amohammedabdelraheem1/se/Hardware/[DC.DC.301] DC-DC Step Down Converter 2A USB (9V-12V-24Vdc to Fixed Output 5V-2A) SKU#DC301.jpg

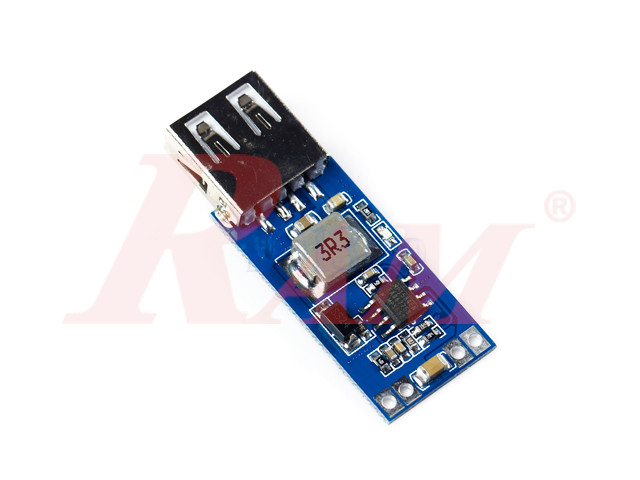
Hardware/[DC.DC.301] DC-DC Step Down Converter 2A USB (9V-12V-24Vdc to Fixed Output 5V-2A) SKU#DC301.jpg
