amohammedabdelraheem1/se/Hardware/bms-18650-3s.webp

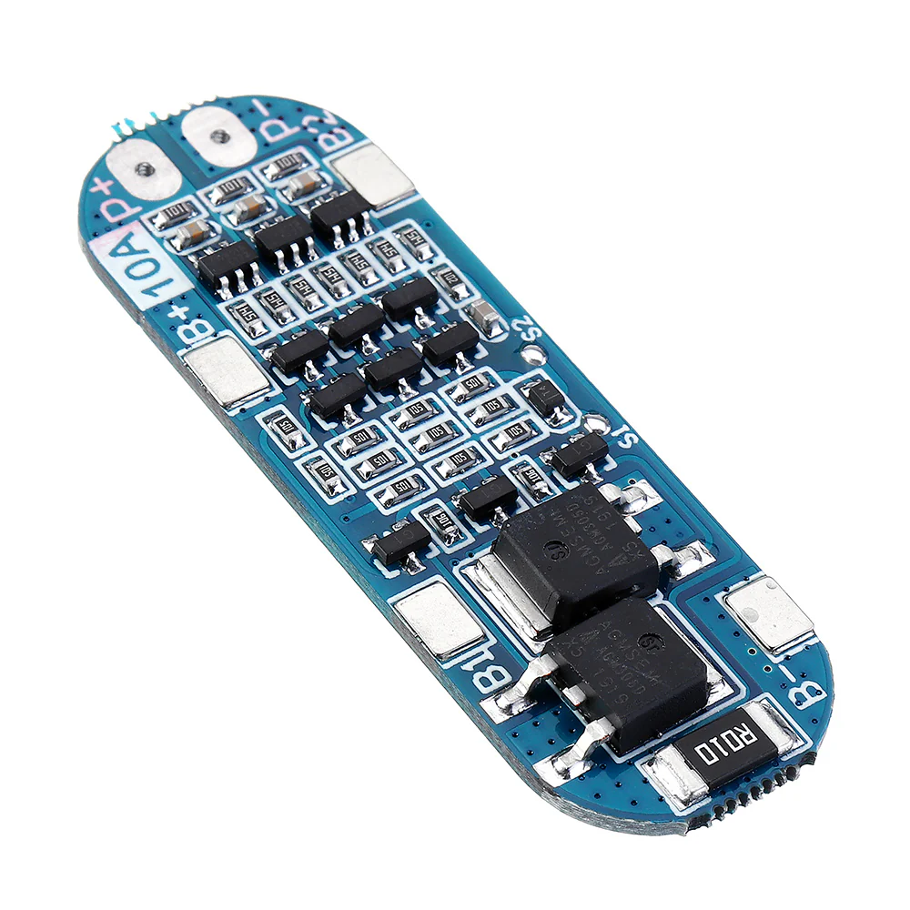
Hardware/bms-18650-3s.webp
