amohammedabdelraheem1/se/PCB/LockBoard/report.txt

Plotted to 'C:\Users\FUTURE\Documents\KiCad\8.0\projects\LockBoard\MainBoardGerber\LockBoard-F_Cu.gbr'.
Plotted to 'C:\Users\FUTURE\Documents\KiCad\8.0\projects\LockBoard\MainBoardGerber\LockBoard-B_Cu.gbr'.
Plotted to 'C:\Users\FUTURE\Documents\KiCad\8.0\projects\LockBoard\MainBoardGerber\LockBoard-F_Paste.gbr'.
Plotted to 'C:\Users\FUTURE\Documents\KiCad\8.0\projects\LockBoard\MainBoardGerber\LockBoard-B_Paste.gbr'.
Plotted to 'C:\Users\FUTURE\Documents\KiCad\8.0\projects\LockBoard\MainBoardGerber\LockBoard-F_Silkscreen.gbr'.
Plotted to 'C:\Users\FUTURE\Documents\KiCad\8.0\projects\LockBoard\MainBoardGerber\LockBoard-B_Silkscreen.gbr'.
Plotted to 'C:\Users\FUTURE\Documents\KiCad\8.0\projects\LockBoard\MainBoardGerber\LockBoard-F_Mask.gbr'.
Plotted to 'C:\Users\FUTURE\Documents\KiCad\8.0\projects\LockBoard\MainBoardGerber\LockBoard-B_Mask.gbr'.
Plotted to 'C:\Users\FUTURE\Documents\KiCad\8.0\projects\LockBoard\MainBoardGerber\LockBoard-Edge_Cuts.gbr'.
Created Gerber job file 'C:\Users\FUTURE\Documents\KiCad\8.0\projects\LockBoard\MainBoardGerber\LockBoard-job.gbrjob'.
Info: Done.
