amohammedabdelraheem1/se/Design/BlockDiagram.png

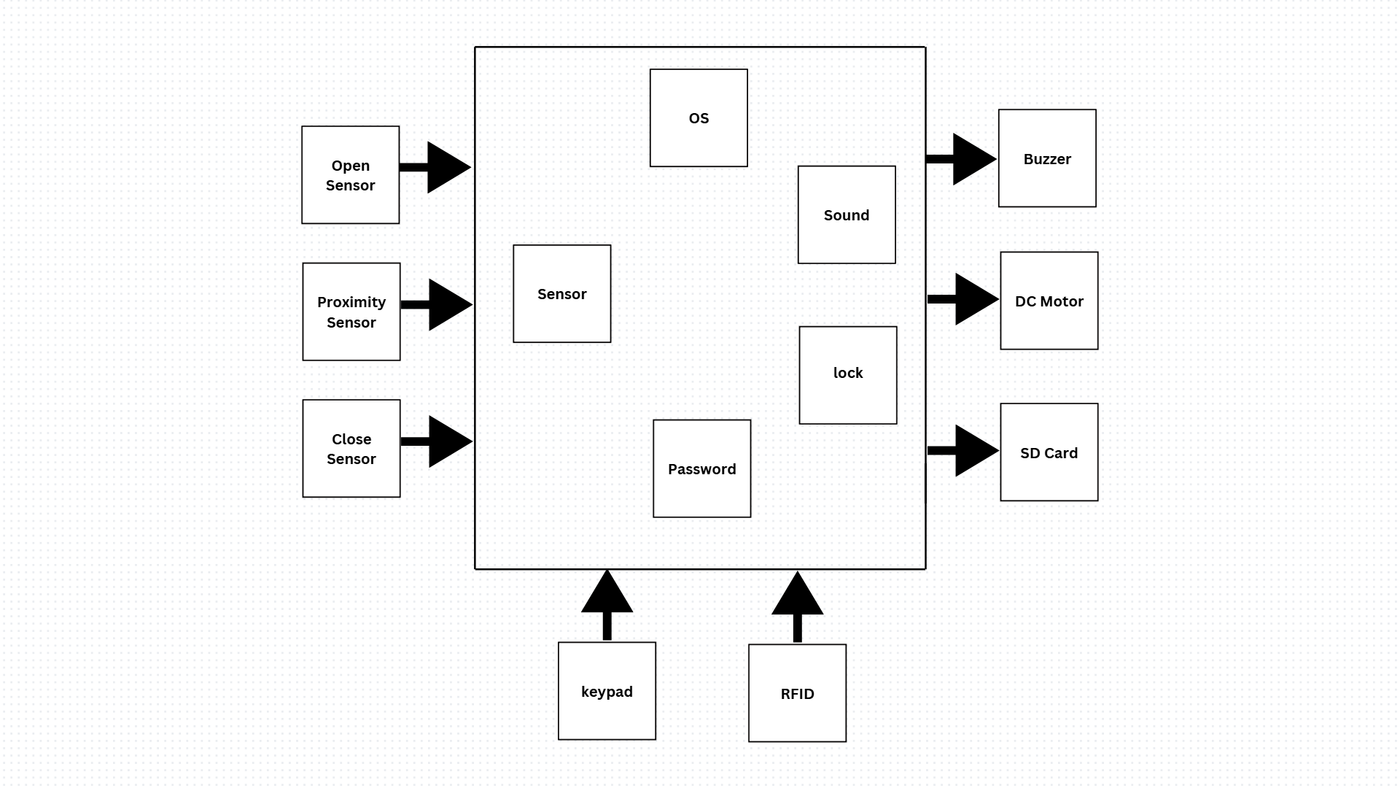
Design/BlockDiagram.png
