amohammedabdelraheem1/se/Design/Modules.png

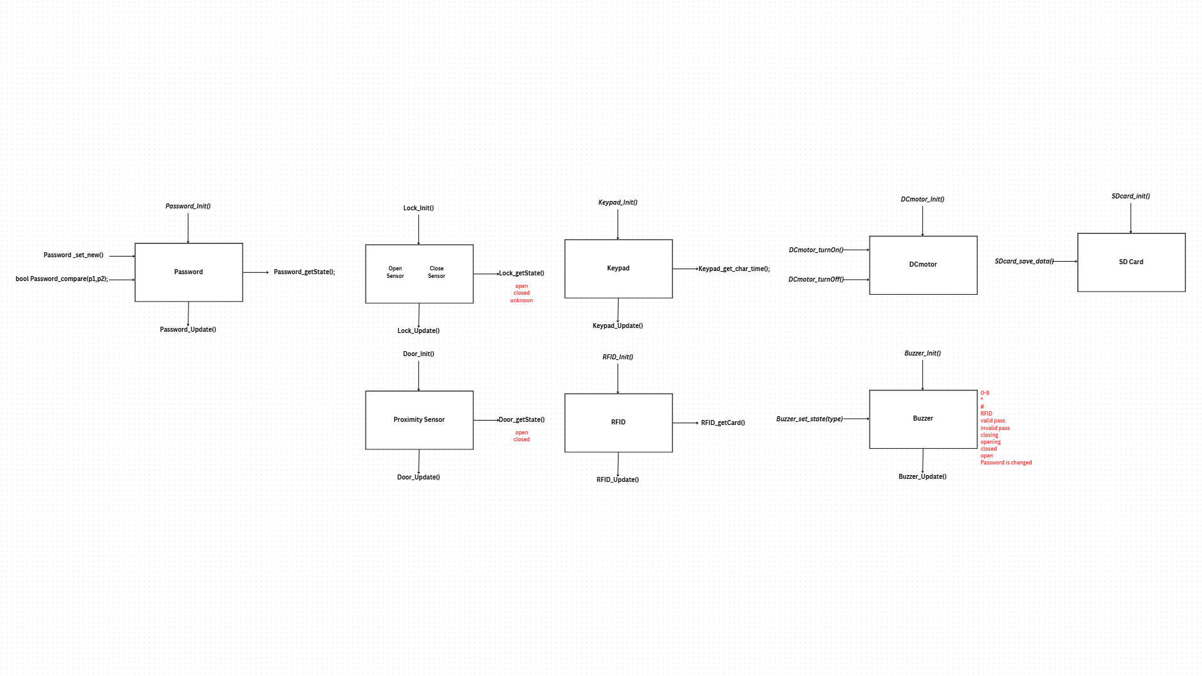
Design/Modules.png
