amohammedabdelraheem1/se/Design/StateMachine.png

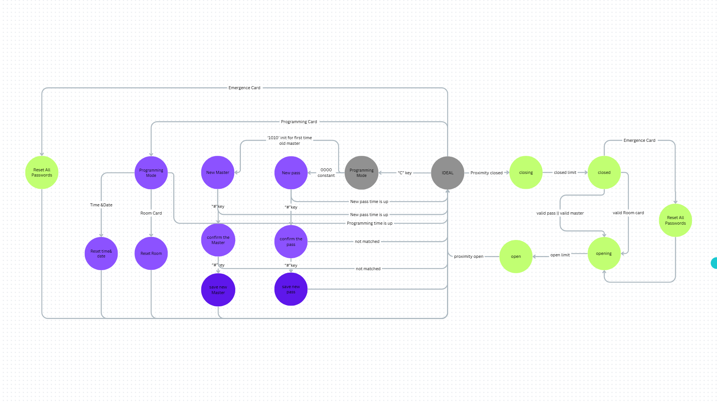
Design/StateMachine.png
