amohammedabdelraheem1/se/Hardware/6pin_diag.png

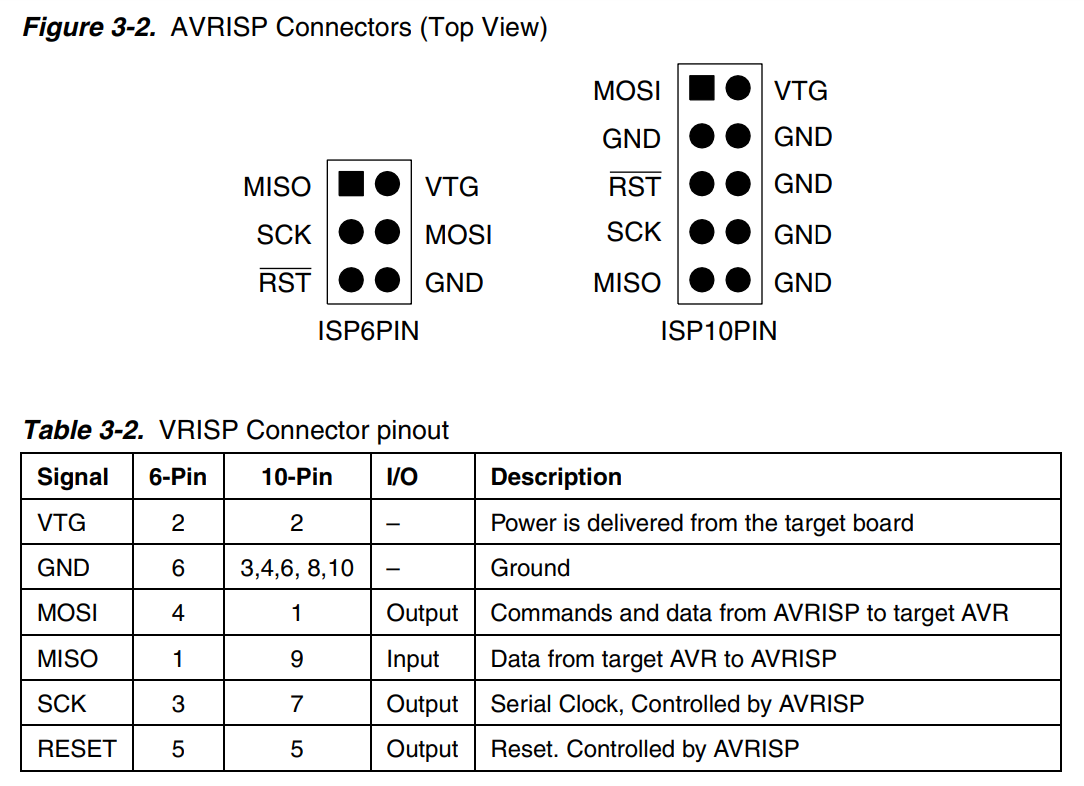
Hardware/6pin_diag.png
