amohammedabdelraheem1/se/Hardware/bat-02-096-1-usb-output-9v-24v-to.jpg

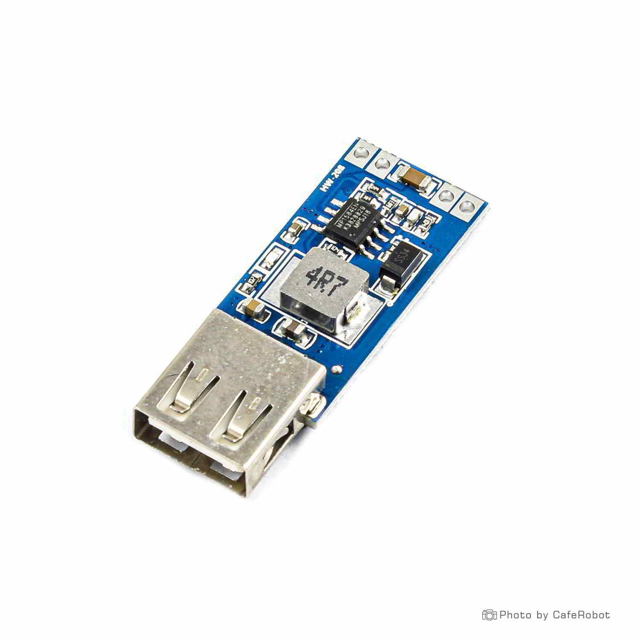
Hardware/bat-02-096-1-usb-output-9v-24v-to.jpg
