amohammedabdelraheem1/se/Hardware/bat-02-096-7-usb-output-9v-24v-to.jpg

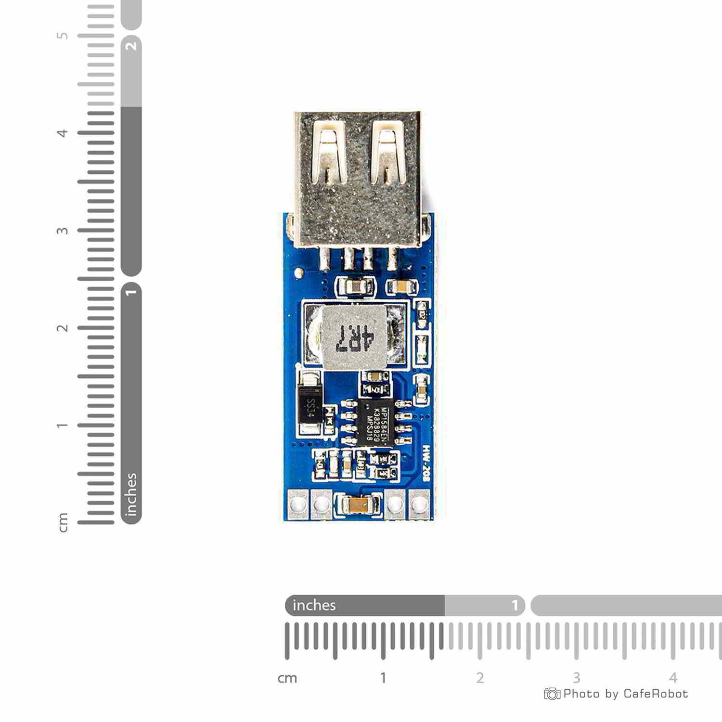
Hardware/bat-02-096-7-usb-output-9v-24v-to.jpg
