amohammedabdelraheem1/se/Hardware/pin_connection.PNG

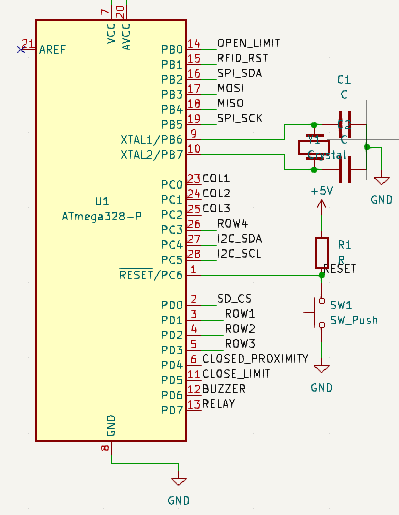
Hardware/pin_connection.PNG
