amohammedabdelraheem1/se/PCB/LockBoard/LockBoard1.png

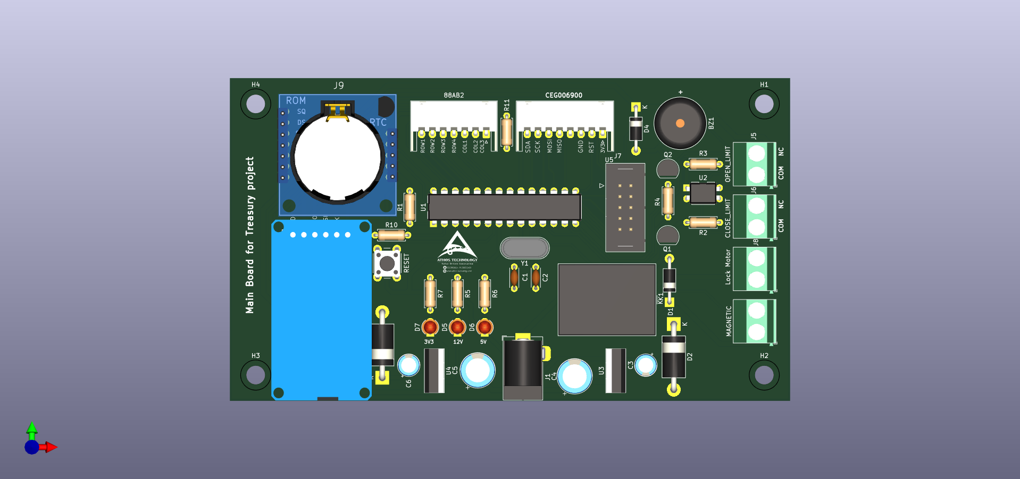
PCB/LockBoard/LockBoard1.png
