amohammedabdelraheem1/se/PCB/PowerBoard/PowerBoard1.jpg

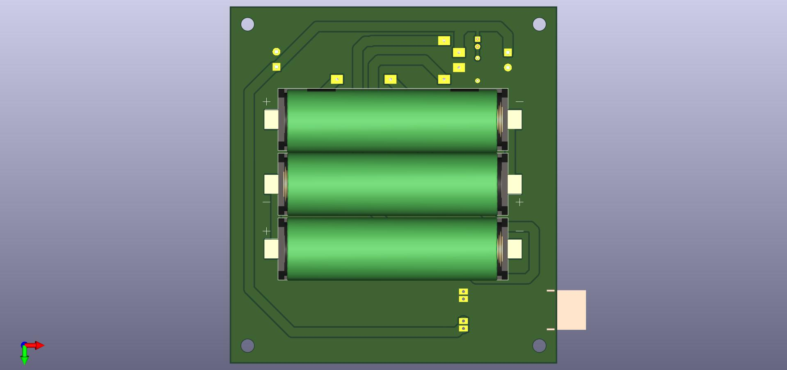
PCB/PowerBoard/PowerBoard1.jpg
