amohammedabdelraheem1/se/PCB/PowerBoard/PowerBoard.jpg

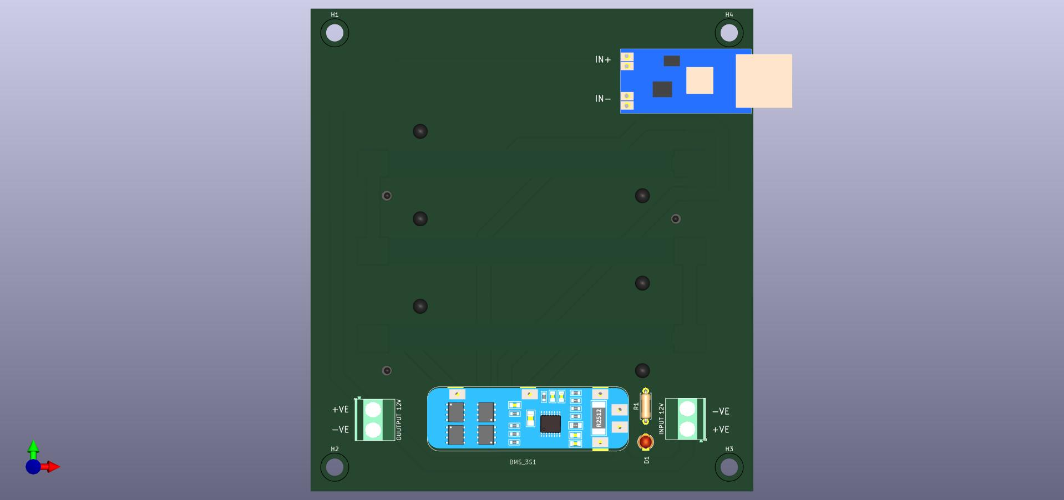
PCB/PowerBoard/PowerBoard.jpg
