amohammedabdelraheem1/se/PCB/PowerBoard/PowerBoard.png

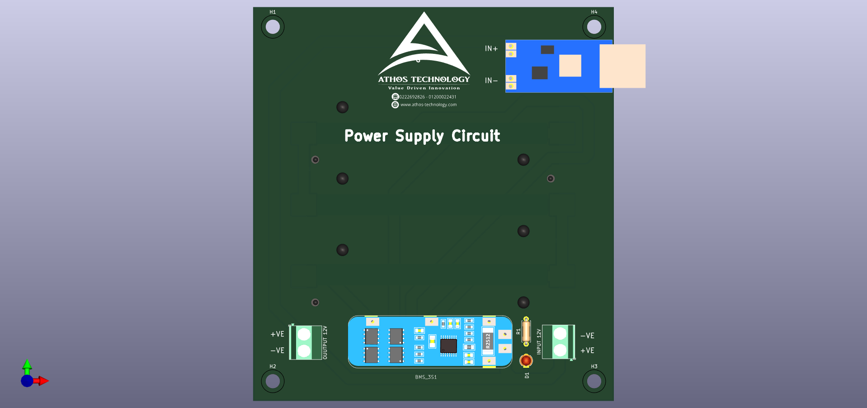
PCB/PowerBoard/PowerBoard.png
