amohammedabdelraheem1/se/(list of files, drawings)

Other design files:
PCB/LockBoard/LockBoard.dsn
