amohammedabdelraheem1/se/PCB/LockBoard/LockBoard.kicad_pcb

## KiCad design PCB/LockBoard/LockBoard.kicad_pcb (2025-07-10)

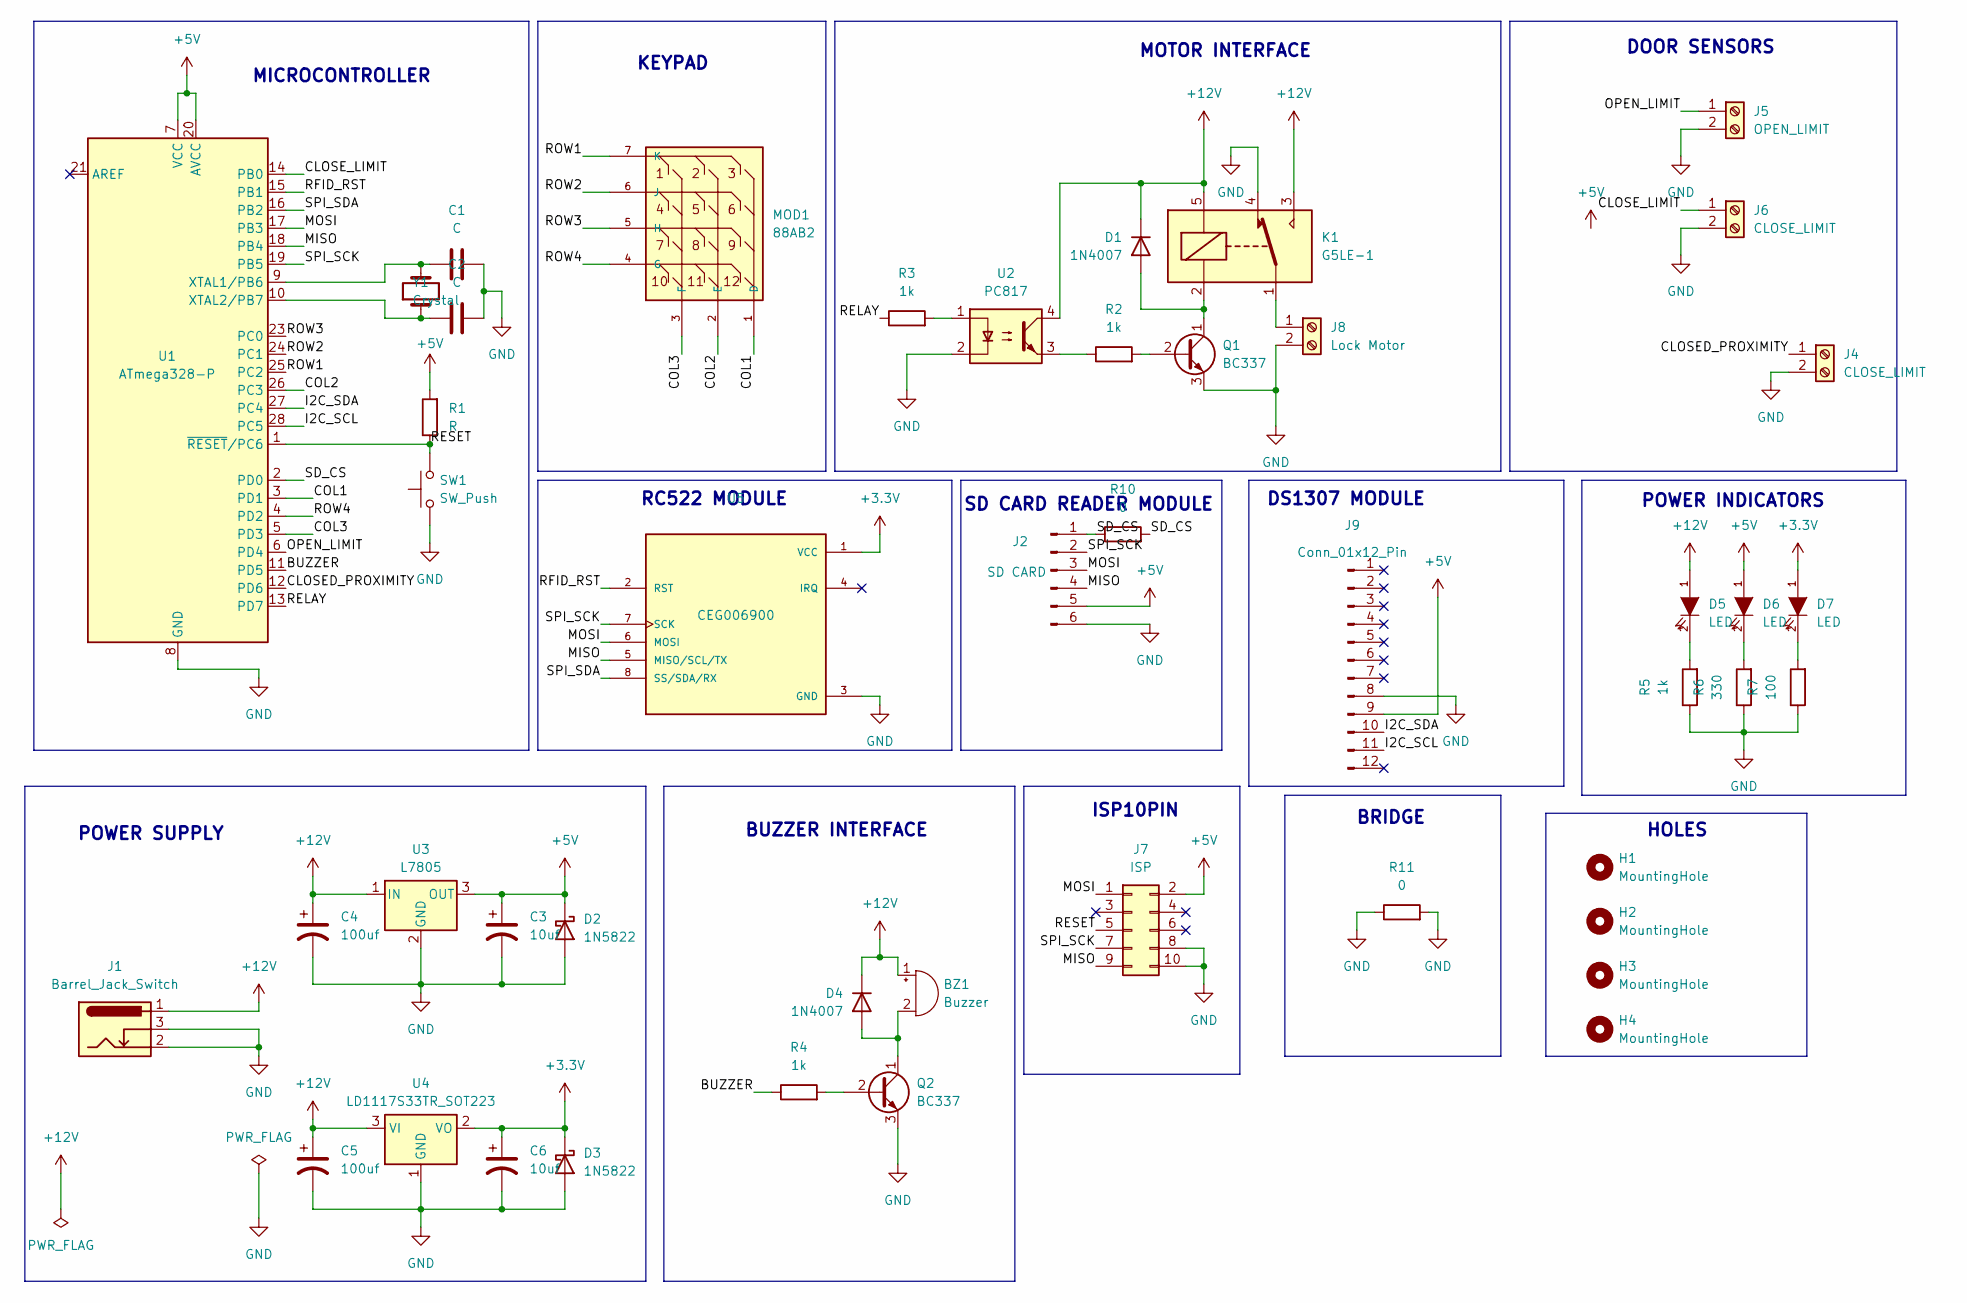
[picture p15: schematic LockBoard.kicad_sch, Lock Board]

Parts:
BZ1: Buzzer; Buzzer_12x9.5RM7.6
C1, C2: C; C_Disc_D4.3mm_W1.9mm_P5.00mm
C3, C6: 10uf; CP_Radial_D5.0mm_P2.50mm
C4, C5: 100uf; CP_Radial_D8.0mm_P2.50mm
D1, D4: 1N4007; D_DO-41_SOD81_P10.16mm_Horizontal
D2, D3: 1N5822; D_DO-201AD_P15.24mm_Horizontal
D5, D6, D7: LED; LED_D3.0mm
H1, H2, H3, H4: MountingHole; MountingHole_4.3mm_M4_ISO14580
J1: Barrel_Jack_Switch; BarrelJack_Horizontal
J2: SD CARD; SD_Card_Module
J4, J6: CLOSE_LIMIT; TerminalBlock_Phoenix_MKDS-1,5-2_1x02_P5.00mm_Horizontal
J5: OPEN_LIMIT; TerminalBlock_Phoenix_MKDS-1,5-2_1x02_P5.00mm_Horizontal
J7: ISP; IDC-Header_2x05_P2.54mm_Vertical
J8: Lock Motor; TerminalBlock_Phoenix_MKDS-1,5-2_1x02_P5.00mm_Horizontal
J9: Conn_01x12_Pin; Tiny_RTC_DS1307
K1: G5LE-1; Relay_SPDT_Omron-G5LE-1
MOD1: 88AB2; JST_XH_S7B-XH-A-1_1x07_P2.50mm_Horizontal
Q1, Q2: BC337; TO-92_Inline
R1: R; R_Axial_DIN0207_L6.3mm_D2.5mm_P7.62mm_Horizontal
R2, R3, R4, R5: 1k; R_Axial_DIN0207_L6.3mm_D2.5mm_P7.62mm_Horizontal
R6: 330; R_Axial_DIN0207_L6.3mm_D2.5mm_P7.62mm_Horizontal
R7: 100; R_Axial_DIN0207_L6.3mm_D2.5mm_P7.62mm_Horizontal
R10, R11: 0; R_Axial_DIN0207_L6.3mm_D2.5mm_P7.62mm_Horizontal
SW1: SW_Push; SW_PUSH_6mm
U1: ATmega328-P; DIP-28_W7.62mm
U2: PC817; DIP-4_W7.62mm
U3: L7805; TO-220-3_Vertical
U4: LD1117S33TR_SOT223; TO-220-3_Vertical
U5: CEG006900; JST_XH_S8B-XH-A-1_1x08_P2.50mm_Horizontal; PARTREV 12 June 2019
Y1: Crystal; Crystal_HC49-4H_Vertical

Connections:
+3.3V: C6.1, D3.1 (K), D7.1 (A), U4.2 (VO), U5.1 (VCC)
+5V: C3.1, D2.1 (K), D6.1 (A), J2.5, J7.2, J9.9, R1.2, U1.7 (VCC), U1.20 (AVCC), U3.3 (OUT)
+12V: BZ1.1 (+), C4.1, C5.1, D1.1 (K), D4.1 (K), D5.1 (A), J1.1, K1.3, K1.5, U2.4, U3.1 (IN), U4.3 (VI)
/BUZZER: R4.1, U1.11 (PD5)
/CLOSED_PROXIMITY: J4.1, U1.12 (PD6); also elsewhere on the board
/CLOSE_LIMIT: J6.1, U1.14 (PB0)
/COL1: MOD1.1 (D), U1.3 (PD1)
/COL2: MOD1.2 (E), U1.26 (PC3)
/COL3: MOD1.3 (F), U1.5 (PD3)
/I2C_SCL: J9.11, U1.28 (PC5)
/I2C_SDA: J9.10, U1.27 (PC4)
/MISO: J2.4, J7.9, U1.18 (PB4), U5.5 (MISO/SCL/TX)
/MOSI: J2.3, J7.1, U1.17 (PB3), U5.6 (MOSI)
/OPEN_LIMIT: J5.1, U1.6 (PD4)
/RELAY: R3.1, U1.13 (PD7)
/RESET: J7.5, R1.1, SW1.2, U1.1 (~RESET/PC6)
/RFID_RST: U1.15 (PB1), U5.2 (RST)
/ROW1: MOD1.7 (K), U1.25 (PC2)
/ROW2: MOD1.6 (J), U1.24 (PC1)
/ROW3: MOD1.5 (H), U1.23 (PC0)
/ROW4: MOD1.4 (G), U1.4 (PD2)
/SD_CS: J2.1, R10.1, R10.2, U1.2 (PD0)
/SPI_SCK: J2.2, J7.7, U1.19 (PB5), U5.7 (SCK)
/SPI_SDA: U1.16 (PB2), U5.8 (SS/SDA/RX)
GND: C1.2, C2.2, C3.2, C4.2, C5.2, C6.2, D2.2 (A), D3.2 (A), J1.2, J1.3, J2.6, J4.2, J5.2, J6.2, J7.8, J7.10, J8.2, J9.8, K1.4, Q1.3 (E), Q2.3 (E), R5.1, R6.1, R7.1, R11.1, R11.2, SW1.1, U1.8 (GND), U1.22 (GND), U2.2, U3.2 (GND), U4.1 (GND), U5.3 (GND); also elsewhere on the board
unnamed: BZ1.2 (-), D4.2 (A), Q2.1 (C)
unnamed: D1.2 (A), K1.2, Q1.1 (C)
unnamed: D5.2 (K), R5.2
unnamed: D6.2 (K), R6.2
unnamed: D7.2 (K), R7.2
unnamed: J8.1, K1.1
unnamed: Q1.2 (B), R2.2
unnamed: Q2.2 (B), R4.2
unnamed: R2.1, U2.3
unnamed: R3.2, U2.1
unnamed: C1.1, U1.9 (XTAL1/PB6), Y1.2
unnamed: C2.1, U1.10 (XTAL2/PB7), Y1.1

Notes on the sheet:
MOTOR INTERFACE
HOLES
BRIDGE
POWER SUPPLY
POWER INDICATORS
ISP10PIN
BUZZER INTERFACE
DOOR SENSORS
SD CARD READER MODULE
RC522 MODULE
DS1307 MODULE
MICROCONTROLLER
KEYPAD

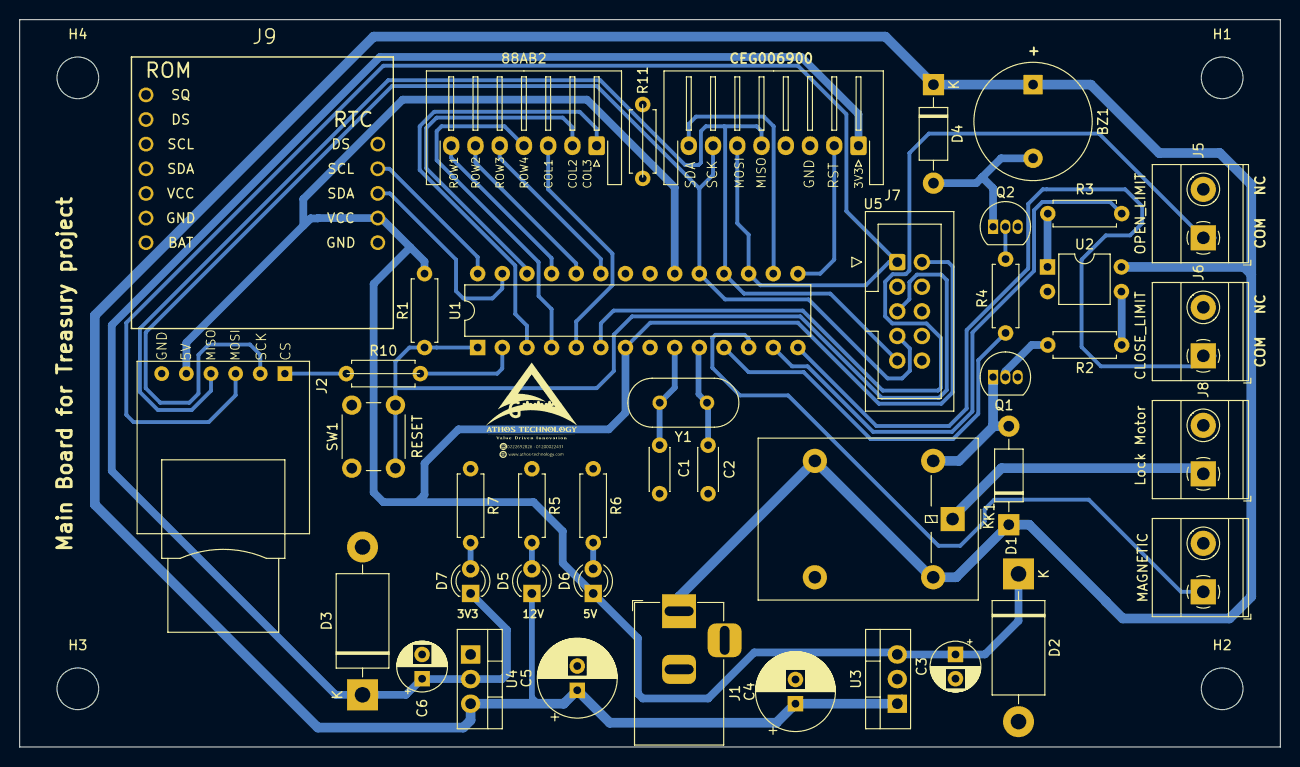
[picture p16: board LockBoard.kicad_pcb from above]

Board: 2 copper layers, 130.0 x 75.0 mm, 46 parts (0 on the bottom side), 37 nets.

Other parts of the board:
MAGNETIC: CLOSE_LIMIT; TerminalBlock_Phoenix_MKDS-1,5-2_1x02_P5.00mm_Horizontal

Their connections:
/CLOSED_PROXIMITY: MAGNETIC.1; also elsewhere on the board
GND: MAGNETIC.2; also elsewhere on the board
