amohammedabdelraheem1/se/PCB/PowerBoard/PowerBoard.kicad_pcb

## KiCad design PCB/PowerBoard/PowerBoard.kicad_pcb (2025-07-10)

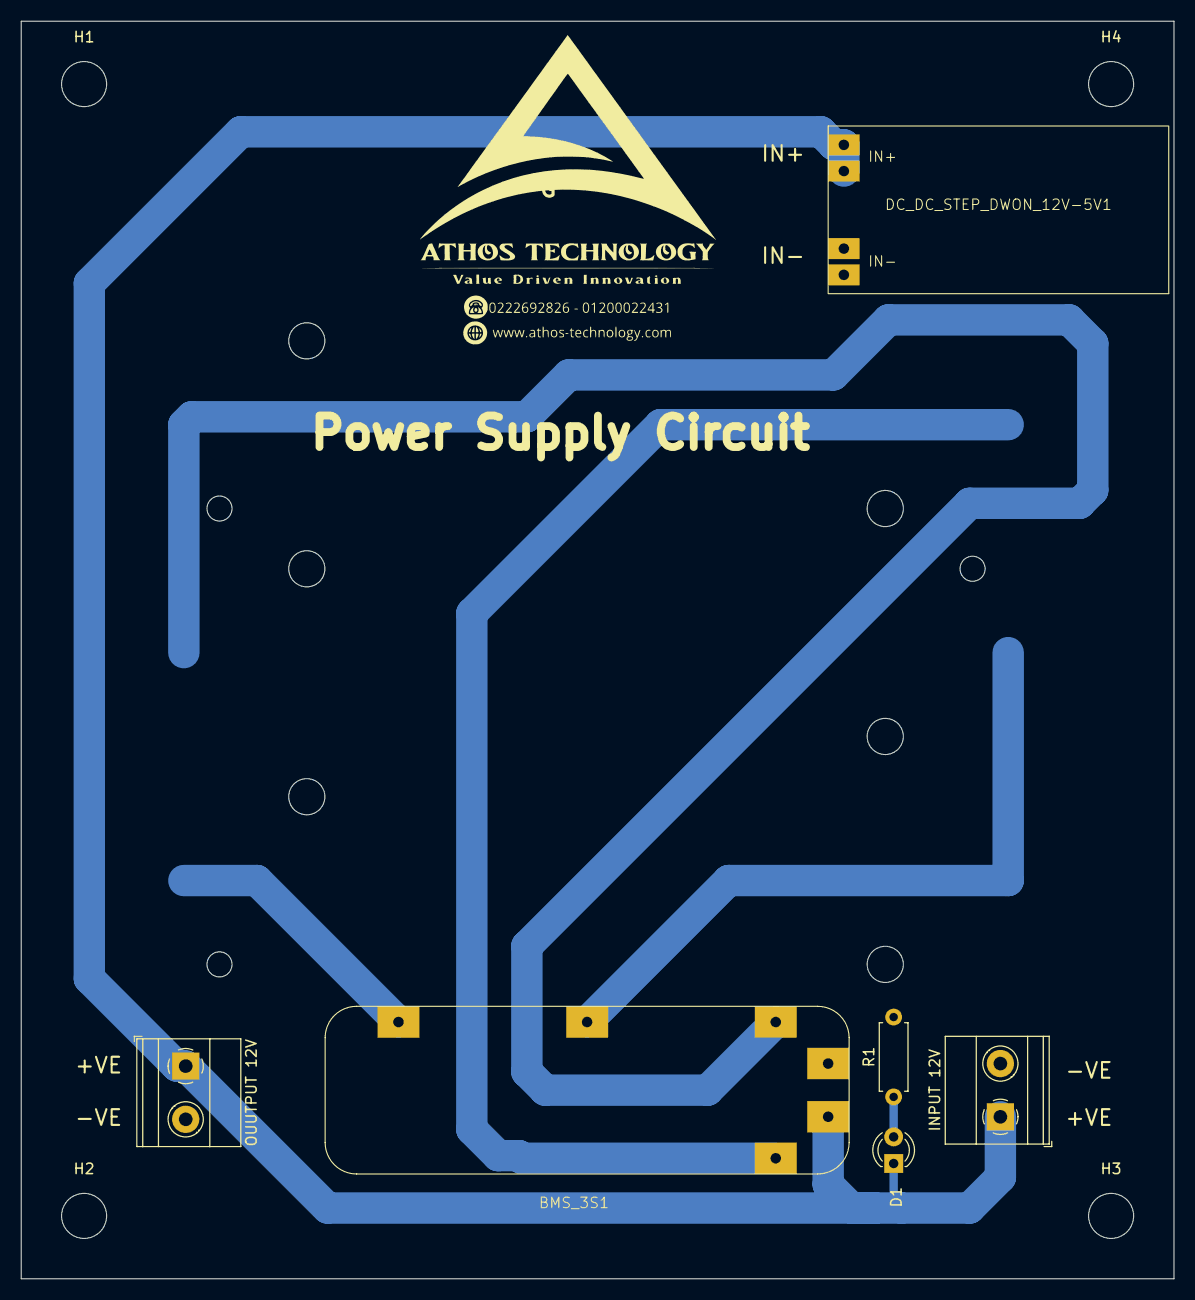
[picture p17: board PowerBoard.kicad_pcb from above]

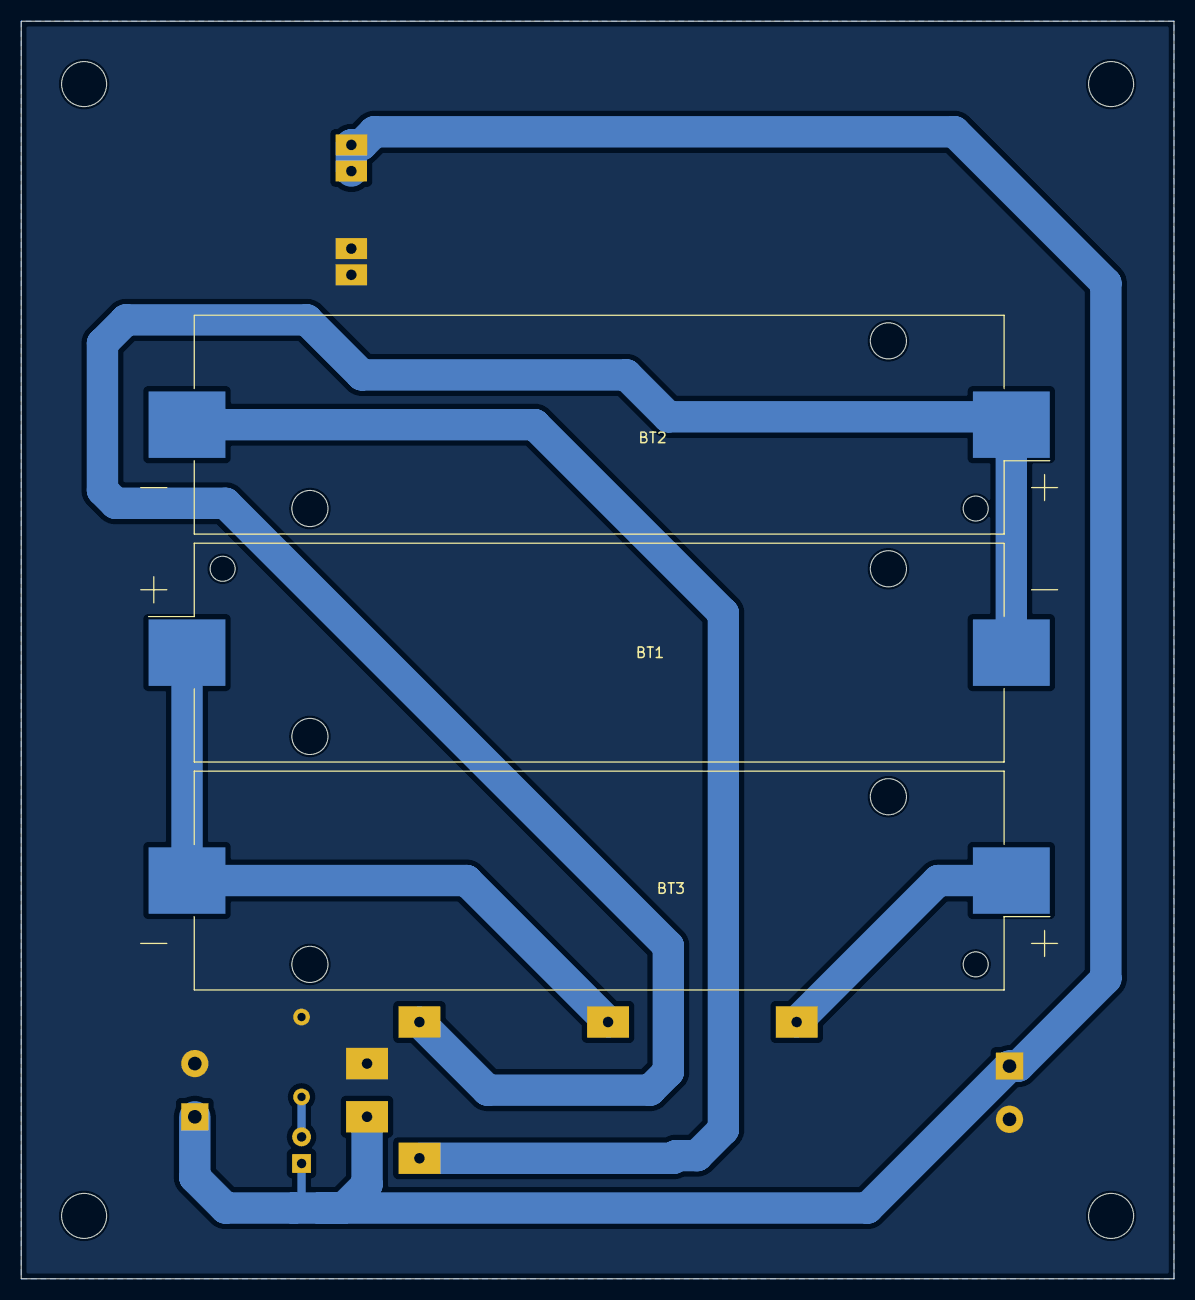
[picture p18: board PowerBoard.kicad_pcb from below]

Board: 2 copper layers, 110.0 x 120.0 mm, 13 parts (3 on the bottom side), 7 nets.

Parts:
BMS_3S1: BMS_3S
BT1, BT2, BT3: Battery_Cell; BatteryHolder_Keystone_1042_1x18650
D1: LED; LED_D3.0mm
DC_DC_STEP_DWON_12V-5V1: DC_DC_STEP_DOWN_12V-5V
H1, H2, H3, H4: MountingHole; MountingHole_4.3mm_M4_ISO14580
INPUT 12V: IN; TerminalBlock_Phoenix_MKDS-1,5-2-5.08_1x02_P5.08mm_Horizont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
OUUTPUT 12V: OUT; TerminalBlock_Phoenix_MKDS-1,5-2-5.08_1x02_P5.08mm_Horizont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
R1: R; R_Axial_DIN0207_L6.3mm_D2.5mm_P7.62mm_Horizontal

Connections:
+12V: BMS_3S1.6 (P+), D1.1 (A), DC_DC_STEP_DWON_12V-5V1.1 (in+), INPUT 12V.1, OUUTPUT 12V.1
GND: BMS_3S1.5 (P-), DC_DC_STEP_DWON_12V-5V1.2 (in-), INPUT 12V.2, OUUTPUT 12V.2, R1.2
unnamed: BMS_3S1.2 (B1), BT1.1 (+), BT2.2 (-)
unnamed: BMS_3S1.3 (B2), BT2.1 (+), BT3.2 (-)
unnamed: BMS_3S1.4 (B+), BT3.1 (+)
unnamed: BMS_3S1.1 (B-), BT1.2 (-)
unnamed: D1.2 (K), R1.1
