amohammedabdelraheem1/se/Code/Safe_lock_project/rfid.h

/******************************************************************************

   Module: RFID

   Description: Header file for the RFID driver

   Author: Ahmed Mohammed Abdelraheem

 ******************************************************************************/

#ifndef RFID_H_
#define RFID_H_
#include <MFRC522.h>
#include <Arduino.h>
#include "common_types.h"
/**************************************************************/
#ifdef __cplusplus
extern "C" {
#endif // __cplusplus
#define TYPE_BYTE_NUM 0
#define ID_BYTE_NUM 3
#define MONTH_DAY_BYTE_NUM 7
#define YEAR_BYTE_NUM 8
#define MINET_BYTE_NUM 9
#define HOUR_BYTE_NUM 10
#define ROOM_BYTE_NUM 11
#define FLOOR_BYTE_NUM 12
#define BUILDING_BYTE_NUM 13
#define CRC_BYTE_NUM 15
#define SYNC_MINET_BYTE_NUM 13
#define SYNC_HOUR_BYTE_NUM 10
#define SYNC_MONTH_DAY_BYTE_NUM 11
#define SYNC_YEAR_BYTE_NUM 12

typedef struct
{
  uint8_t Type;
  uint8_t ID;
  tDate ExpirdDate;
  tLocation CardLocation;
  uint8_t CRC;
} tCard;  // currentCard ,prevCard

typedef enum {
  AUTHORISED = 0x00,
  ROOM = 0x08,
  TIMESYNC = 0x0C,
  //FLOOR      = 0x30,
  //BUILDING   = 0x34,
  MASTER = 0x2E,
  EMRGANCY = 0x29,
  CLIENT = 0x18,
  OTHER = 0xFF
} tType;

void RFID_Init(void);
void CARD_Init(void);
void CardRead(void);
void CARD_Update(void);
void CHECK_VALIDATION_Init(void) ;
void CHECK_VALIDATION_Update(void);
void CardDataDisplay(void);
tUserState CHECK_VALIDATION_GetState(void);

#ifdef __cplusplus
}
#endif // __cplusplus

#endif /* RFID_H_ */
