amohammedabdelraheem1/se/Code/Safe_lock_project/common_types.h

#ifndef COMMON_TYPES_H_
#define COMMON_TYPES_H_
#include <Arduino.h>// Include the standard types header file
#ifdef __cplusplus
extern "C" {
#endif // __cplusplus

typedef struct
{
  uint8_t Room;
  uint8_t Floor;
  uint8_t Building;
} tLocation;  // UnitLocation
typedef struct
{
  uint8_t Minute;
  uint8_t Hour;
  uint8_t Day;
  uint8_t Month;
  uint8_t Year;
} tDate;  //CurrentDate ,SyncDate
typedef enum {
  INVALID_STATE,
  VALID_STATE
} tUserState;

#ifdef __cplusplus
}
#endif // __cplusplus

#endif /* COMMON_TYPES_H_ */
