amohammedabdelraheem1/se/Code/Safe_lock_project/lock.h

//#ifndef LOCK_H_
//#define LOCK_H_
//
//// Preprocessor directive to ensure C++ compatibility
//// Prevents name mangling when used in C++ projects
//#ifdef __cplusplus
//extern "C" {
//#endif   //__cplusplus
//#include "std_types.h"
//
//// Interrupt Service Routine for open limit switch
//// Triggered when open limit switch is activated
////void Lock_openLimit_ISR(void);
//
//// Interrupt Service Routine for close limit switch
//// Triggered when close limit switch is activated
////void Lock_closeLimit_ISR(void);
//
//// Preprocessor directive to close C++ compatibility block
//#ifdef __cplusplus
//}
//#endif   //__cplusplus
//
//// Header guard to prevent multiple inclusions
//#endif  //LOCK_H_
