amohammedabdelraheem1/se/(commit log)

2025-07-10 init commit
    [LockBoard-B_Cu.gbr, LockBoard-B_Mask.gbr, LockBoard-B_Paste.gbr, LockBoard-B_Silkscreen.gbr, LockBoard-Edge_Cuts.gbr, LockBoard-F_Cu.gbr, LockBoard-F_Mask.gbr, LockBoard-F_Paste.gbr]
2025-07-21 Lock and rfid tested open lock at setup and lock the door when it is closed motor rotate Mx 2sec
2025-07-24 implement all modules in cpp and h file error compiling for arduino
    [Safe_lock_project.ino, buzzer.c, common_types.h, dc_motor.c, door.cpp, door.h, keypad.c, keypad.h]
2025-07-25 final implementation of modules ini .cpp and .h files without any errors
    [common_types.h]
2025-07-25 final implementation of modules ini .cpp and .h files without any errors2
    [keypad.h, password.h, rfid.cpp, rfid.h, rtc.h, unit.h]
